the-control-cabinet/heating-plant-monitoring-esphome/hardware/opto-tray/opto-board-tray-v2.stl

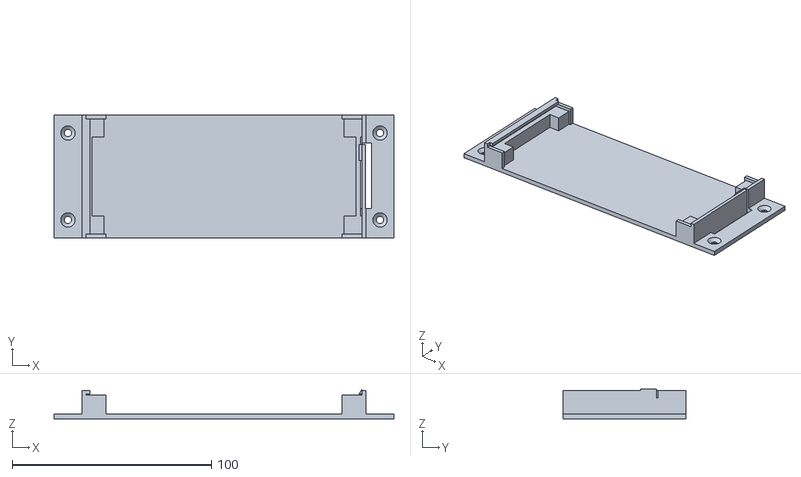
[picture p23: CAD file, 2026-11-02]
hardware/opto-tray/opto-board-tray-v2.stl
170.6 x 61.6 x 15.1
