the-control-cabinet/heating-plant-monitoring-esphome/(commit log)

2026-10-28 Update to remove OT to new repo
    [commissioning-tests.csv, tuning-log.csv]
2026-10-29 Junction box survey 29 Oct 2026: as-built wiring, safety checks, bypass finding, opto re-scope, new FDD rules
    [io-schedule.csv]
2026-10-31 Batch 1: core-level wiring map, boiler earth finding, fault history, cylinder data, ESP32 incident update
2026-11-02 Batch 2: gateway RF stall investigation and watchdog, opto board 8 inputs and tray v2, NTC filters, F1 evidence, ESPHome 2026.10.2, AiMesh records
    [io-schedule.csv, opto-board-tray-v2.scad, opto-board-tray-v2.stl]
2026-11-06 Batch 4: Niagara/Trend/PLC/BACnet plan folded in; gateway stall decoded and fixed in test (jc1), HCC80R UFH demand decoding, NTC resistor fix, pressure calibration and noise, cylinder outlet NTC and 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
    [io-schedule.csv]
2026-11-11 Batch 5: control-room off-board rewiring and as-built schematics, opto enclosure, clamp and tundish fixes, cylinder stratification and hot water estimate, short cycling and load scaling measured, FDD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
    [io-schedule.csv]
2026-11-11 Schematics: opto VCC/GND, live/neutral/earth wiring; ESP32 right-side GND feeds to the off-board buses
2026-11-11 Batch 6: plumber visit and cylinder commissioning, left/right sensor corrections, alerts package live (FDD rules), hot water estimate v3 with per-cylinder draw capture, probe position and legionella 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
    [io-schedule.csv]
2026-11-11 Batch 6b: photos (vessels and label, inlet gauges, tundish plates, opto enclosure, PRV), the evening's graphs, and the reheat-cut-short alert fix
